evyd13/gud70-pcb/README.md

# Gud70 PCB

This is a replacement PCB for the Uniqey C70. Manufacturing files are included.

Some boards do not come with the LED seperator thingy, to prevent light bleed, so there is one that can be 3d printed as well.

Please read the license before use.
