evyd13/gud70-pcb/led-seperator/drawings/20200528_161955.jpg

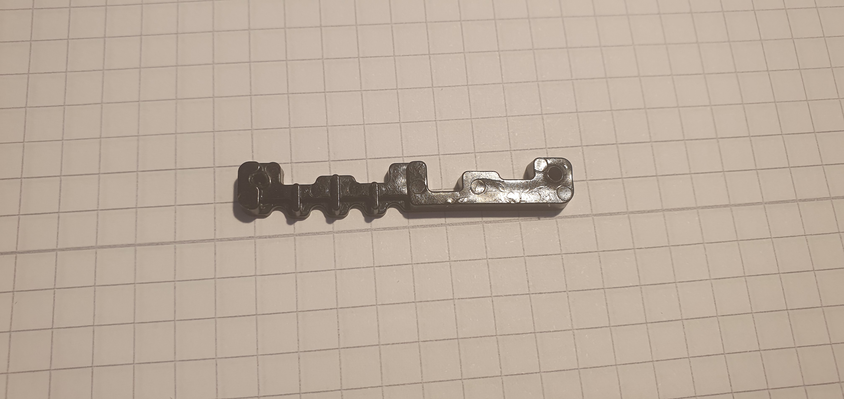
led-seperator/drawings/20200528_161955.jpg
