evyd13/gud70-pcb/led-seperator/drawings/20200528_162533.jpg

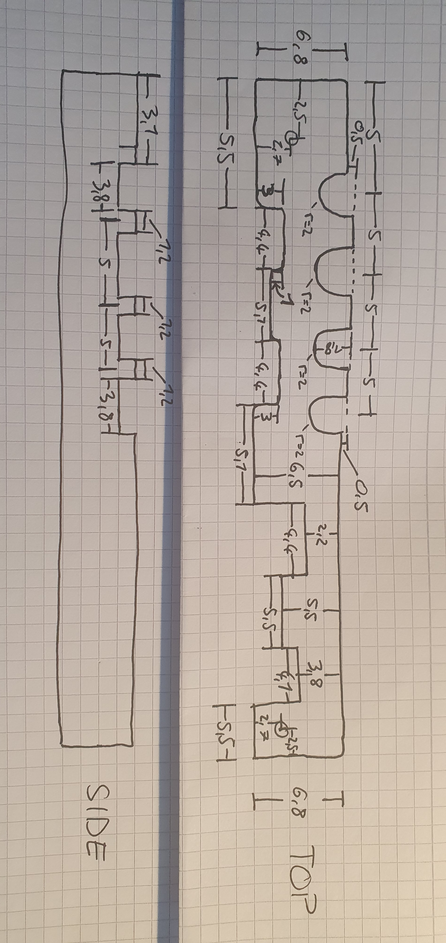
led-seperator/drawings/20200528_162533.jpg
