evyd13/gud70-pcb/pcb-files/manufacturing/Gud70 BOM.xls

Gud70 BOM
Manufacturer | Manufacturer Part Number (required) | Designator (required) | Qty (required) | Description (required) | Case | SMD ,BGA,LCC,OR TH | Top/Bottom | points (number of contacts the IC has in each board) | Total points (number of contacts per BOM line has) | Comment
Samsung Electro-Mechanics | CL21B104KBCNNNC | C2-C5 | 4 | 100nf capacitor | 0805 | SMD | Bottom
Samsung Electro-Mechanics | CL21A475KAQNNNE | C6 | 1 | 4.7uf capacitor | 0805 | SMD | Bottom
Samsung Electro-Mechanics | CL21A105KBCLNNC | C1 | 1 | 1uf capacitor | 0805 | SMD | Bottom
LIZ Elec | CD4148WSP | D1-D67, D72, D75-D80 | 74 | Switching diode | 0805 | SMD | Bottom
Walsin Tech Corp | WR08X103JTL | R5, R6 | 2 | 10k ohm resistor | 0805 | SMD | Bottom
Walsin Tech Corp | WR08X220JTL | R1, R2 | 2 | 22 ohm resistor | 0805 | SMD | Bottom
Walsin Tech Corp | WR08X102JTL | R101-R104 | 4 | 1k ohm resistor | 0805 | SMD | Bottom
Microchip Tech | ATMEGA32U4-AU | U1 | 1 | Microcontroller | QFP-44 | SMD | Bottom |  |  | Do not substitute
STMicroelectronics | USBLC6-2SC6 | U2 | 1 | Diode ESD | SOT-23-6 | SMD | Bottom |  |  | Do not substitute
Murata Electronics | CSTNE16M0V530000R0 | X1 | 1 | Resonator |  | SMD | Bottom |  |  | Do not substitute
TLC Electronic | TLC-PSMD050 | F1 | 1 | PTC Fuse | 0805 | SMD | Bottom
JST Sales America | SM04B-SRSS-TB(LF)(SN) | J3 | 1 | Board connector |  | SMD | Bottom
Everlight | 27-21/W1D-ANPHY/3C | LED1-LED4 | 4 | LED |  | SMD | Top |  |  | Do not substitute
Korean Hroparts Elec | K2-1187SQ-A4SW-06 | SW1 | 1 | Tactile switch |  | SMD | Top
