evyd13/gud70-pcb/led-seperator/led-seperator.stl

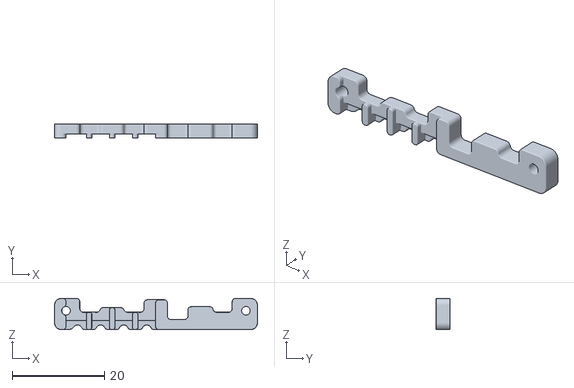
[picture p7: CAD file, 2021-02-24]
led-seperator/led-seperator.stl
44.0 x 3.10 x 6.80
