evyd13/gud70-pcb/(list of files, cad)

Other CAD files:
led-seperator/C70-led-seperator.f3d
